Tinkerforge/nfc-rfid-bricklet/software/examples/labview/Example Scan For Tags.vi.png

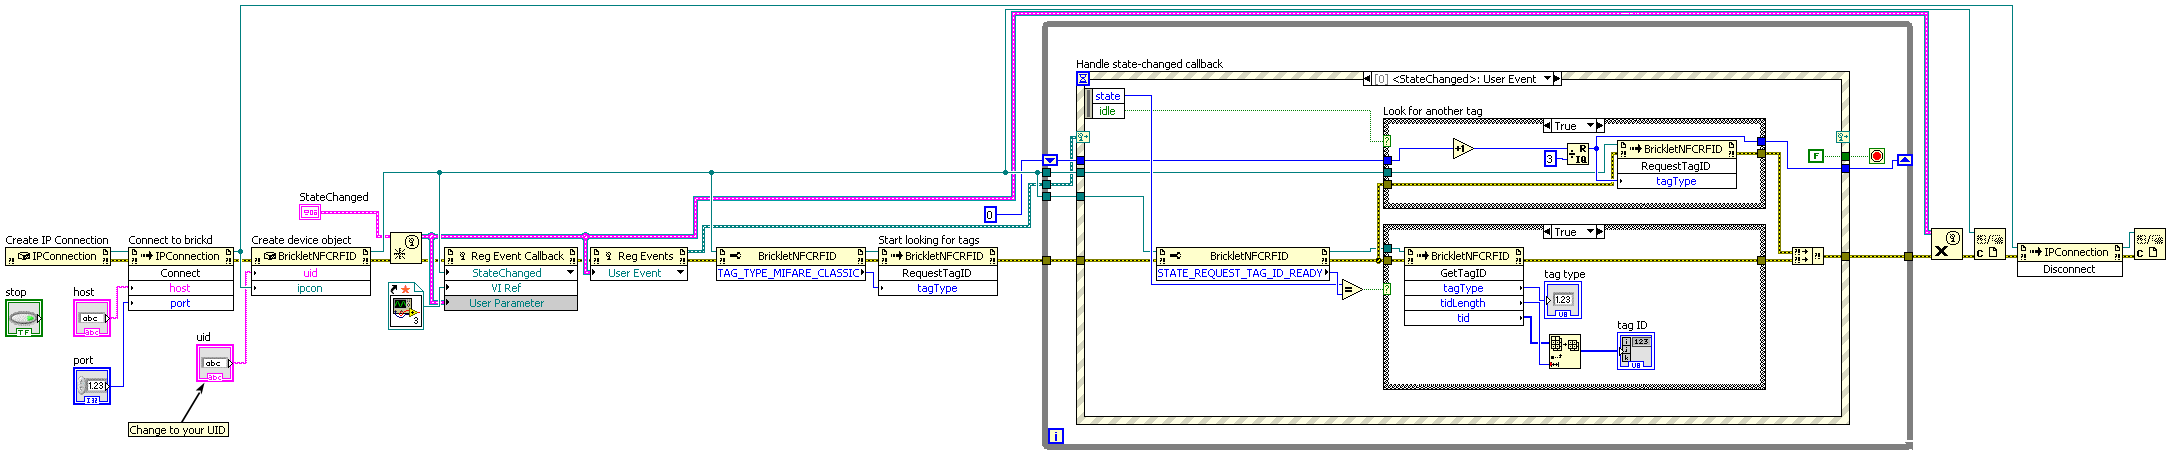
software/examples/labview/Example Scan For Tags.vi.png
