Tinkerforge/nfc-rfid-bricklet/software/examples/labview/Example Write Read Type 2.vi.png

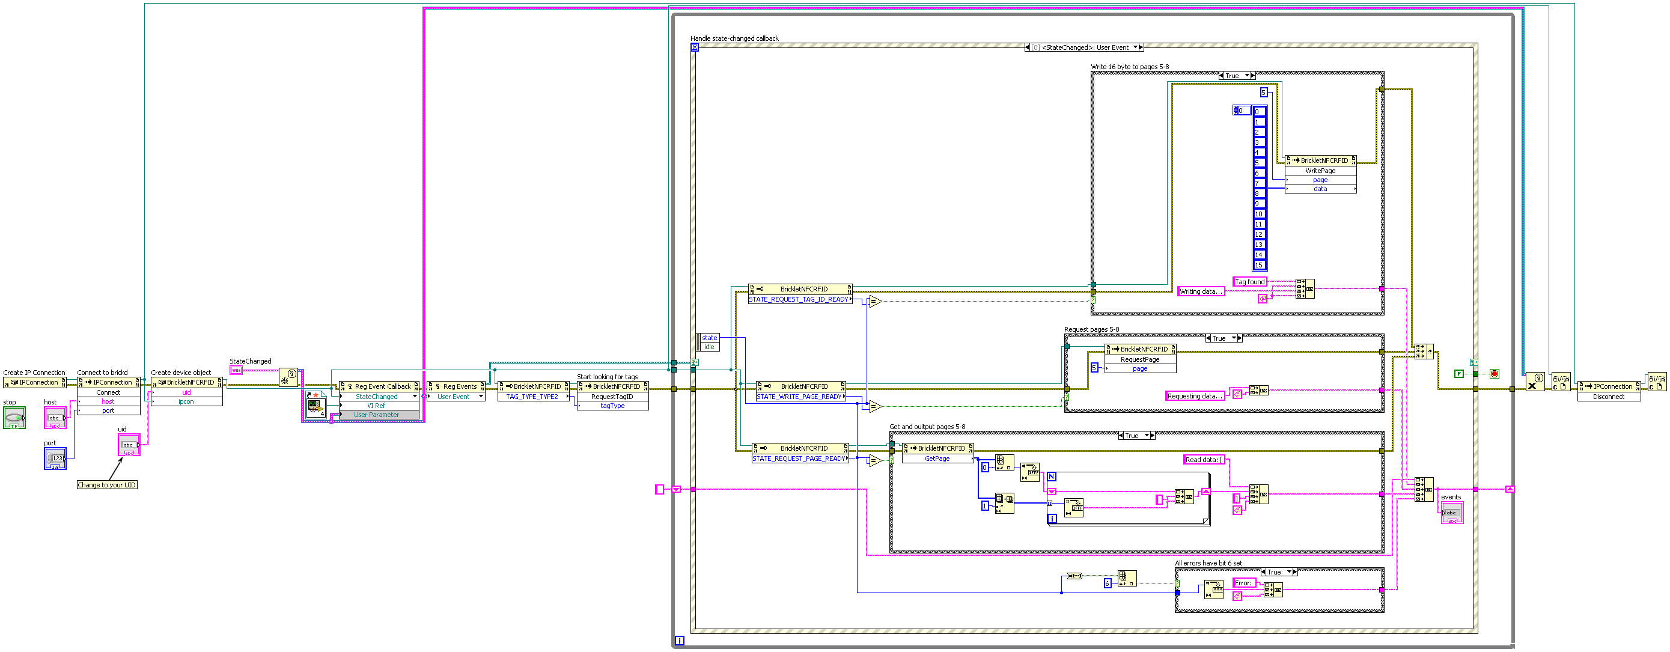
software/examples/labview/Example Write Read Type 2.vi.png
