Tinkerforge/nfc-rfid-bricklet/hardware/nfc-rfid-schematic.pdf

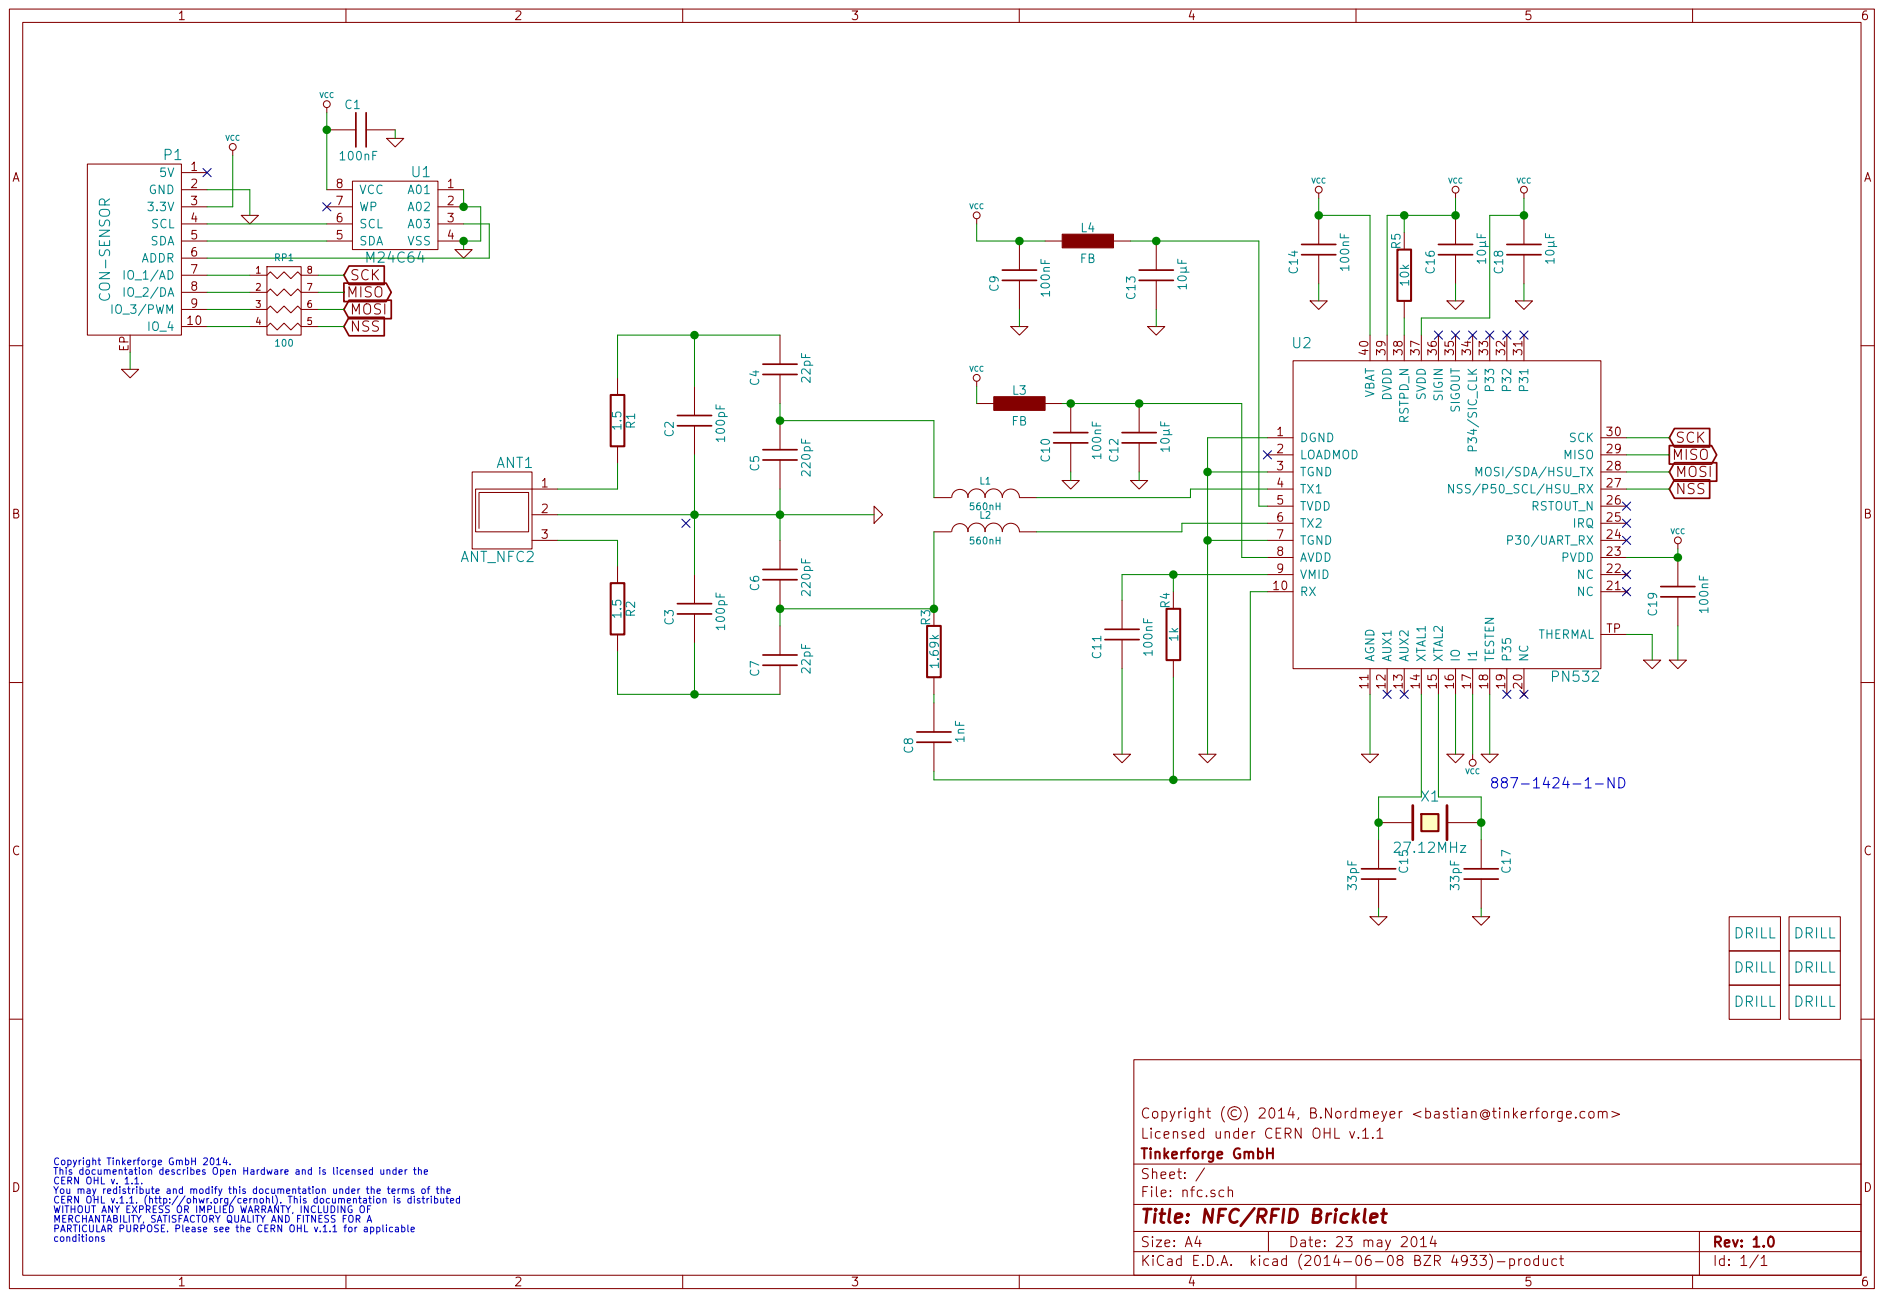
[picture p3: page 1]

Licensed under CERN OHL v.1.1 Copyright (©) 2014, B.Nordmeyer <bastian@tinkerforge.com>

Id: 1/1 Title: NFC/RFID Bricklet File: nfc.sch Sheet: / Tinkerforge GmbH

Copyright Tinkerforge GmbH 2014. This documentation describes Open Hardware and is licensed under the CERN OHL v. 1.1. You may redistribute and modify this documentation under the terms of the CERN OHL v.1.1. (http://ohwr.org/cernohl). This documentation is distributed WITHOUT ANY EXPRESS OR IMPLIED WARRANTY, INCLUDING OF MERCHANTABILITY, SATISFACTORY QUALITY AND FITNESS FOR A

PARTICULAR PURPOSE. Please see the CERN OHL v.1.1 for applicable
