Tinkerforge/nfc-rfid-bricklet/hardware/nfc-rfid.kicad_pcb

## KiCad design hardware/nfc-rfid.kicad_pcb (2018-03-05)

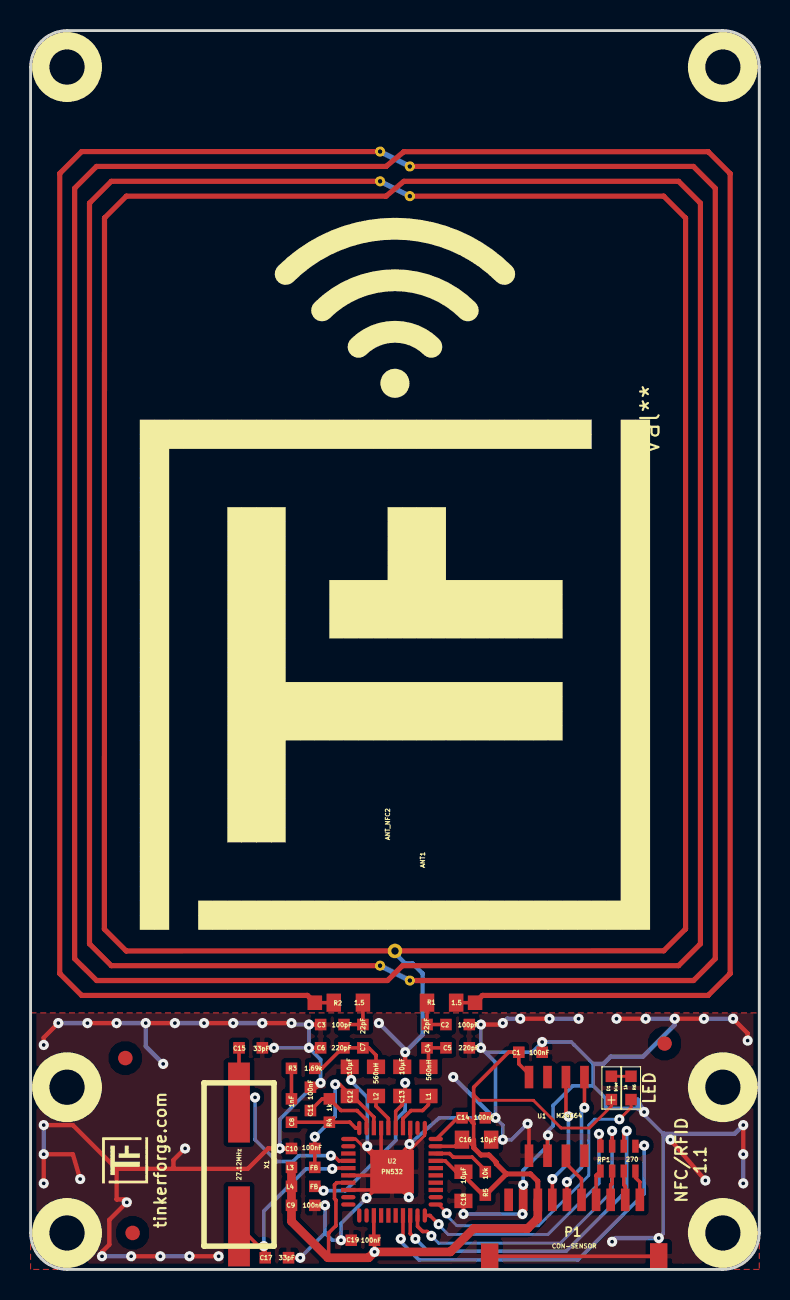
[picture p4: board nfc-rfid.kicad_pcb from above]

Board: 2 copper layers, 50.0 x 85.0 mm, 49 parts (0 on the bottom side), 31 nets.

Parts:
ANT1: ANT_NFC2; NFC_ANTENNA2
C1, C9, C10, C11, C14, C19: 100nF; 0603
C2, C3: 100pF; 0603
C4, C7: 22pF; 0603
C5, C6: 220pF; 0603
C8: 1nF; 0603
C12, C13, C16, C18: 10µF; 0805
C15, C17: 33pF; 0603
D1: blue; D0603
Fiducial_Mark: VAL**; Fiducial_Mark
Fiducial_Mark#2, Fiducial_Mark#3: VAL**; Fiducial_Mark
L1, L2: 560nH; 0805
L3, L4: FB; 0603
P1: CON-SENSOR
R1, R2: 1.5; 0805
R3: 1.69k; 0603
R4, R6: 1k; 0603
R5: 10k; 0603
RP1: 270; 0603X4
TF_ICON_35: TF_ICON_35
TF_ICON_35_FLIP: Val**; TF_ICON_35_FLIP
U1: M24C64; SOIC8
U2: PN532; QFN40-6x6
U3, U4, U5, U6, U7, U8: DRILL; DRILL_NP
VAL: CE_5mm
VAL#2: WEEE_7mm
X1: 27.12MHz; US

Connections:
GND: ANT1.2, C1.2, C2.1, C3.2, C5.1, C6.2, C9.1, C10.1, C11.1, C12.1, C13.1, C14.1, C15.2, C16.1, C17.2, C18.1, C19.1, P1.2, P1.EP, U1.1, U1.2, U1.4, U2.1, U2.3, U2.7, U2.11, U2.16, U2.18, U2.TP
MISO: RP1.7, U2.29
MOSI: RP1.6, U2.28
NSS: RP1.5, U2.27
unnamed: ANT1.1, R1.2
unnamed: ANT1.3, R2.1
unnamed: C2.2, C4.2, R1.1
unnamed: C3.1, C7.1, R2.2
unnamed: C4.1, C5.2, L1.1
unnamed: C6.1, C7.2, L2.1, R3.2
unnamed: C8.1, R4.1, U2.10
unnamed: C8.2, R3.1
unnamed: C10.2, C12.2, L3.2, U2.8
unnamed: C11.2, R4.2, U2.9
unnamed: C13.2, L4.2, U2.5
unnamed: C15.1, U2.14, X1.1
unnamed: C17.1, U2.15, X1.2
unnamed: D1.2, R6.2
unnamed: L1.2, U2.4
unnamed: L2.2, U2.6
unnamed: P1.4, U1.6
unnamed: P1.5, U1.5
unnamed: P1.6, U1.3
unnamed: P1.7, RP1.1
unnamed: P1.8, RP1.2
unnamed: P1.9, RP1.3
unnamed: P1.10, RP1.4
unnamed: R5.1, U2.38
unnamed: R6.1, U2.31
SCK: RP1.8, U2.30
VCC: C1.1, C9.2, C14.2, C16.2, C18.2, C19.2, D1.1, L3.1, L4.1, P1.3, R5.2, U1.8, U2.17, U2.23, U2.37, U2.39, U2.40
