Tinkerforge/nfc-rfid-bricklet/(commit log)

2014-05-09 Add very first working version (reads and prints mifare uid), no communication yet
2014-06-13 change SPI pins according to hardware prototype
2014-06-13 nfc/rfid bricklet hardware files
    [nfc.kicad_pcb, nfc.sch]
2014-07-08 fix resistor value for spi series resistor fix component name and value positions
    [nfc.kicad_pcb, nfc.sch]
2014-08-05 Unify print and variable naming style in examples
2014-12-22 Asynchronously wait until pn532 is ready (fixes RED Brick incompatibility)
    [config.h, nfc-rfid.c]
2015-08-07 Use full device class name in Python examples
2015-11-12 shell: Add comment and remove debug print
2016-05-18 c: Add missing device destroy call
2017-08-01 Remove "currently in development" note
2018-02-20 Cleanup KiCad libraries config
    Ensure LibDir=kicad-libraries and LibName1=tinkerforge.
    Remove special library.
2018-05-11 Rename files
    [nfc-rfid.kicad_pcb, nfc-rfid.sch]
2018-10-31 examples: Avoid race condition between requesting the next tag ID and getting the current one
2021-10-25 Update KiCad link
    https://www.kicad.org/blog/2021/10/Avoid-links-to-former-kicad-domain/
